mpinese/electronics-uldosc/bom.xlsx

Designator | Value | Footprint | DigiKey | Quantity
C1, C3 | 10u | Capacitor_THT:CP_Radial_D5.0mm_P2.00mm | P1176-ND | 2
C2 | 100n | Capacitor_SMD:C_1206_3216Metric | 445-6984-1-ND | 1
C4 | 47u | Capacitor_THT:CP_Radial_D6.3mm_P2.50mm | 493-10493-1-ND | 1
C5-C7 | 22n | Capacitor_THT:C_Rect_L7.2mm_W7.2mm_P5.00mm_FKS2_FKP2_MKS2_MKP2 | 1928-1227-ND | 3
C8 | 47p | Capacitor_SMD:C_0603_1608Metric | 1276-1037-1-ND | 1
C9, C10 | 1000u | Capacitor_THT:CP_Radial_D16.0mm_P7.50mm | 399-6557-ND | 2
C11, C12 | 1u | Capacitor_SMD:C_0603_1608Metric | 1276-1942-1-ND | 2
C13-C20 | 100n | Capacitor_SMD:C_0603_1608Metric | 399-7845-1-ND | 8
D1, D2 | BAV99 | Package_TO_SOT_SMD:SOT-23 | 1727-4311-1-ND | 2
D3, D4 | 1N5246B | Diode_THT:D_DO-35_SOD27_P7.62mm_Horizontal | 1N5246B-ND | 2
J1 | Conn_Coaxial | uld_osc:CONN_1-1337543-0 | A97553-ND | 1
Q1 | BC337 | Package_TO_SOT_THT:TO-92_Inline | BC33716TAFSCT-ND | 1
R1 | 510 | Resistor_SMD:R_0603_1608Metric | RR08P510DCT-ND | 1
R2 | 18 | Resistor_SMD:R_0603_1608Metric | RR08Q18DCT-ND | 1
R3 | 3.48k | Resistor_SMD:R_0603_1608Metric | RG16P3.48KBCT-ND | 1
R4 | 2.2k | Resistor_SMD:R_0603_1608Metric | RR08P510DCT-ND | 1
R6 | 5.6k | Resistor_SMD:R_0603_1608Metric | RR08P5.6KDCT-ND | 1
R7 | 8.2k | Resistor_SMD:R_0603_1608Metric | RR08P8.2KDCT-ND | 1
R8 | 715 | Resistor_SMD:R_0603_1608Metric | RR08P715DCT-ND | 1
R9 | 9.1k | Resistor_SMD:R_0603_1608Metric | RR08P9.1KDCT-ND | 1
R5, R10, R12, R14 | 3.6k | Resistor_SMD:R_0603_1608Metric | RG16P3.6KBCT-ND | 4
R11, R13, R15 | 10k | Resistor_SMD:R_0603_1608Metric | RR08P10.0KDCT-ND | 3
R16, R17 | 6.8 | Resistor_SMD:R_0805_2012Metric | 311-2897-1-ND | 2
U1 | NSL-32 | OptoDevice:Luna_NSL-32 | NSL-32SR3-ND | 1
U2, U6 | OPA1611 | Package_SO:SOIC-8_3.9x4.9mm_P1.27mm | 296-47811-1-ND | 2
U3 | TL431DBZ | Package_TO_SOT_SMD:SOT-23 | 296-17332-1-ND | 1
U4 | TL081 | Package_SO:SOIC-8_3.9x4.9mm_P1.27mm | 296-TL081CPSRCT-ND | 1
U5 | TL082 | Package_SO:SOIC-8_3.9x4.9mm_P1.27mm | 296-15005-1-ND | 1
VR1 | 200 | uld_osc:67YR200LF | 987-1503-ND | 1
VR2 | 50k | uld_osc:P160KN2 | 987-1714-ND | 1
K1 | Knob |  | 1722-1313-ND | 1
