mpinese/electronics-uldosc/kicad/uld_osc.kicad_pcb

## KiCad design kicad/uld_osc.kicad_pcb (2020-09-04)

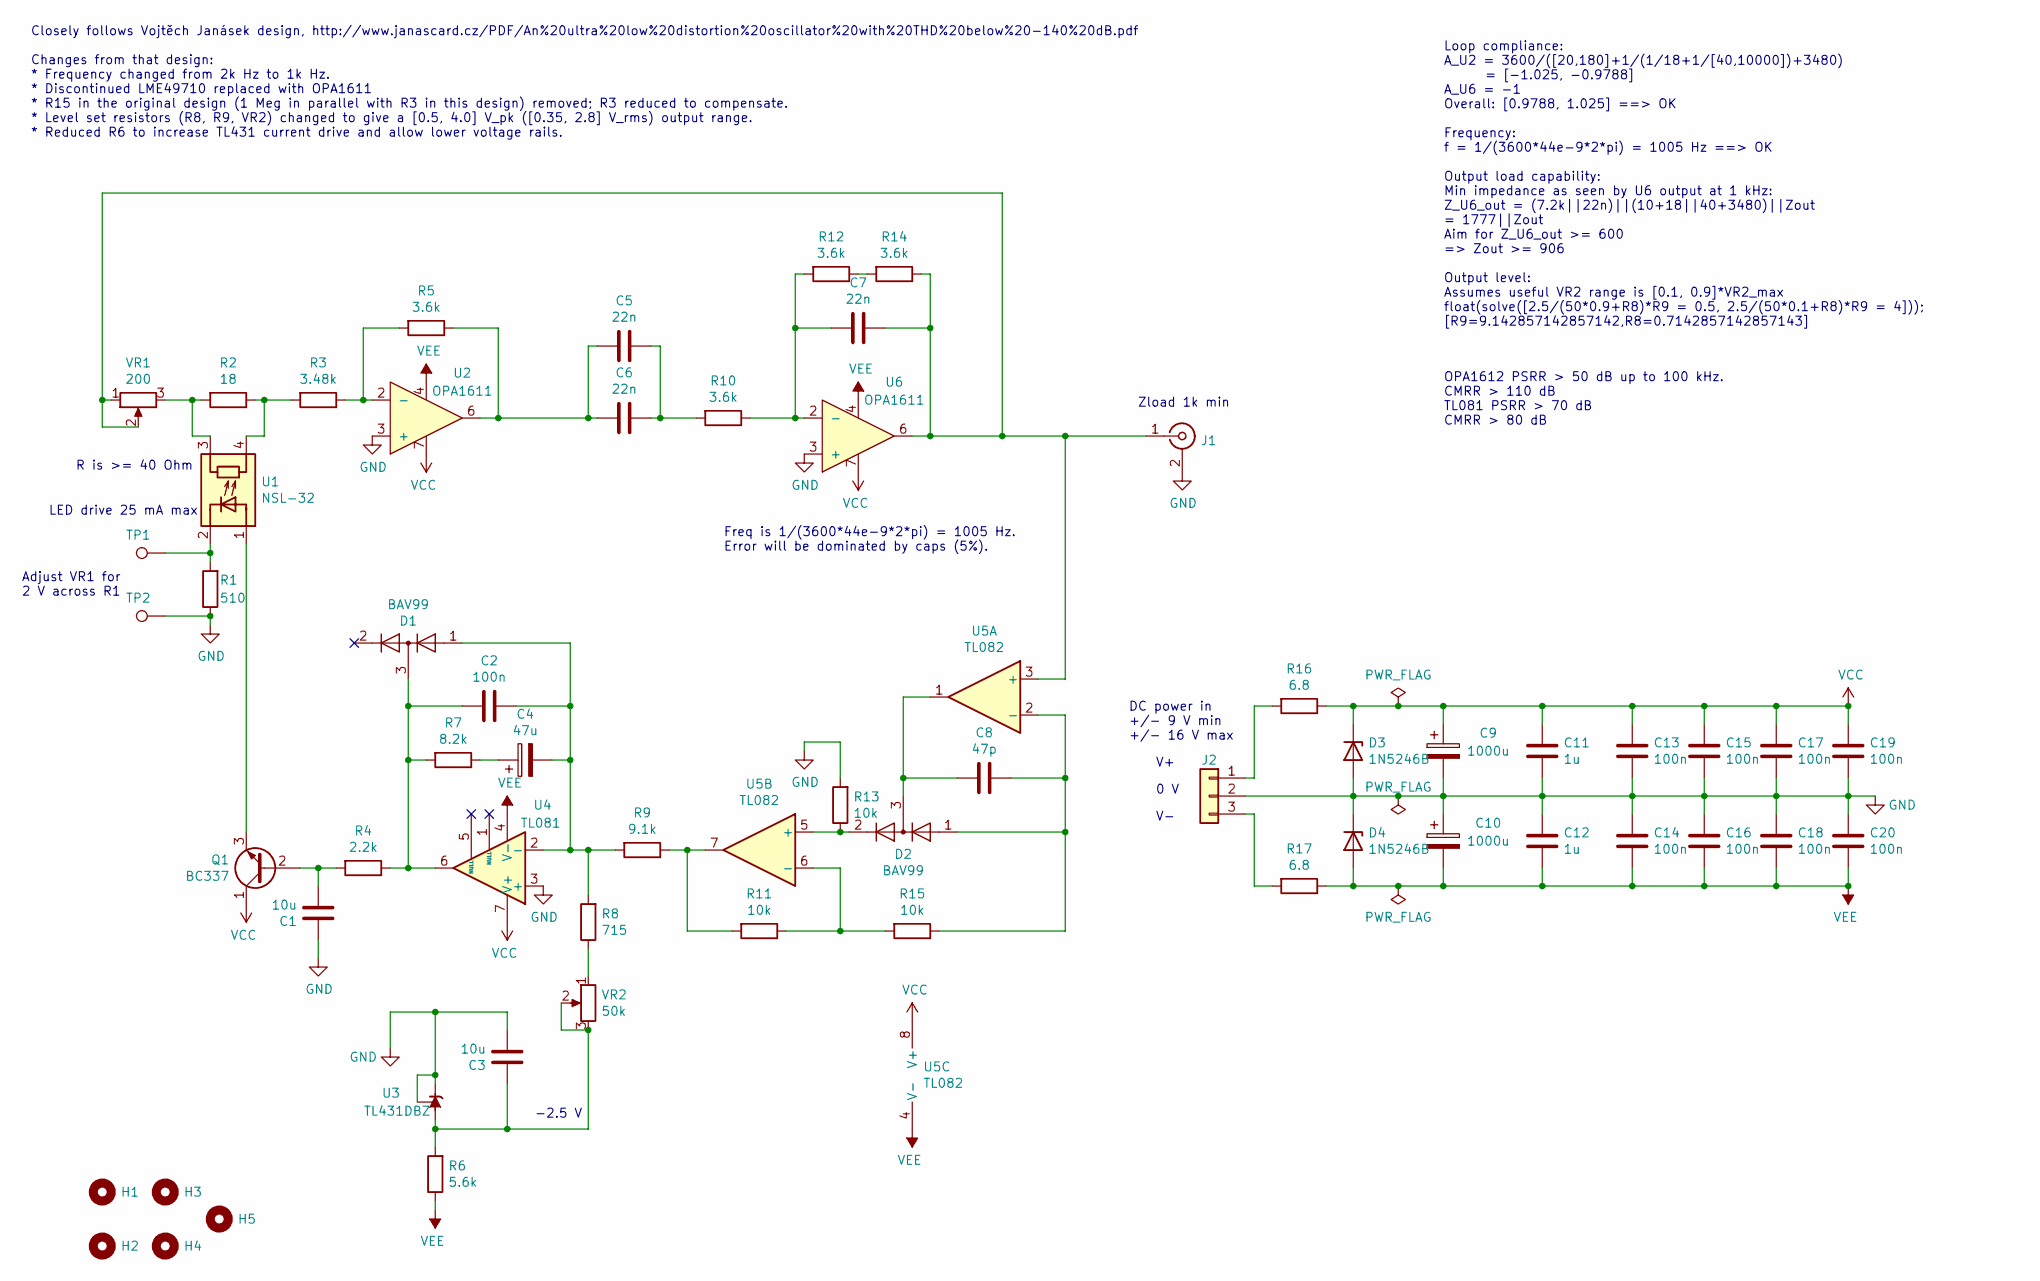
[picture p2: schematic uld_osc.sch, Low noise 1 kHz oscillator]

Parts:
C1, C3: 10u; CP_Radial_D5.0mm_P2.00mm; DigiKey P1176-ND
C2: 100n; C_1206_3216Metric; DigiKey 445-6984-1-ND
C4: 47u; CP_Radial_D6.3mm_P2.50mm; DigiKey 493-10493-1-ND
C5, C6, C7: 22n; C_Rect_L7.2mm_W7.2mm_P5.00mm_FKS2_FKP2_MKS2_MKP2; DigiKey 1928-1227-ND
C8: 47p; C_0603_1608Metric; DigiKey 1276-1037-1-ND
C9, C10: 1000u; CP_Radial_D16.0mm_P7.50mm; DigiKey 399-6557-ND
C11, C12: 1u; C_0603_1608Metric; DigiKey 1276-1942-1-ND
C13, C14, C15, C16, C17, C18, C19, C20: 100n; C_0603_1608Metric; DigiKey 399-7845-1-ND
D1, D2: BAV99; SOT-23; DigiKey 1727-4311-1-ND
D3, D4: 1N5246B; D_DO-35_SOD27_P7.62mm_Horizontal; DigiKey 1N5246B-ND
H1, H2, H3, H4, H5: MountingHole_3.2mm_M3
J1: Conn_Coaxial; CONN_1-1337543-0; DigiKey A97553-ND
J2: Conn_01x03; PinHeader_1x03_P2.54mm_Vertical
Q1: BC337; TO-92_Inline; DigiKey BC33716TAFSCT-ND
R1: 510; R_0603_1608Metric; DigiKey RR08P510DCT-ND
R2: 18; R_0603_1608Metric; DigiKey RR08Q18DCT-ND
R3: 3.48k; R_0603_1608Metric; DigiKey RG16P3.48KBCT-ND
R4: 2.2k; R_0603_1608Metric; DigiKey RR08P2.2KDCT-ND
R5, R10, R12, R14: 3.6k; R_0603_1608Metric; DigiKey RG16P3.6KBCT-ND
R6: 5.6k; R_0603_1608Metric; DigiKey RR08P5.6KDCT-ND
R7: 8.2k; R_0603_1608Metric; DigiKey RR08P8.2KDCT-ND
R8: 715; R_0603_1608Metric; DigiKey RR08P715DCT-ND
R9: 9.1k; R_0603_1608Metric; DigiKey RR08P9.1KDCT-ND
R11, R13, R15: 10k; R_0603_1608Metric; DigiKey RR08P10.0KDCT-ND
R16, R17: 6.8; R_0805_2012Metric; DigiKey 311-2897-1-ND
TP1, TP2: TestPoint; TestPoint_Loop_D2.50mm_Drill1.0mm
U1: NSL-32; Luna_NSL-32; DigiKey NSL-32SR3-ND
U2, U6: OPA1611; SOIC-8_3.9x4.9mm_P1.27mm; DigiKey 296-47811-1-ND
U3: TL431DBZ; SOT-23; DigiKey 296-17332-1-ND
U4: TL081; SOIC-8_3.9x4.9mm_P1.27mm; DigiKey 296-15001-1-ND
U5: TL082; SOIC-8_3.9x4.9mm_P1.27mm; DigiKey 296-15005-1-ND
VR1: 200; 67YR200LF; DigiKey 987-1503-ND
VR2: 50k; P160KN2; DigiKey 987-1714-ND

Connections:
GND: C1.2, C3.1, C9.2, C10.1, C11.2, C12.1, C13.2, C14.1, C15.2, C16.1, C17.2, C18.1, C19.2, C20.1, D3.2 (A), D4.1 (K), J1.2 (Ext), J2.2, R1.1, R13.2, TP2.1, U2.3 (+), U3.1 (K), U3.2 (REF), U4.3 (+), U6.3 (+)
unnamed: C1.1, Q1.2 (B), R4.2
unnamed: C2.1, C4.2, D1.1 (K), R8.2, R9.2, U4.2 (-)
unnamed: C2.2, D1.3 (K), R4.1, R7.2, U4.6
unnamed: C3.2, R6.2, U3.3 (A), VR2.2, VR2.3
unnamed: C4.1, R7.1
unnamed: C5.1, C6.1, R10.2
unnamed: C5.2, C6.2, R5.1, U2.6
unnamed: C7.1, J1.1 (In), R14.1, U5.3 (+), U6.6, VR1.1, VR1.2
unnamed: C7.2, R10.1, R12.2, U6.2 (-)
unnamed: C8.1, D2.1 (K), R15.1, U5.2 (-)
unnamed: C8.2, D2.3 (K), U5.1
unnamed: D2.2 (A), R13.1, U5.5 (+)
unnamed: J2.1, R16.2
unnamed: J2.3, R17.2
unnamed: Q1.3 (E), U1.1 (A)
unnamed: R1.2, TP1.1, U1.2 (K)
unnamed: R2.1, R3.2, U1.4 (R)
unnamed: R2.2, U1.3 (R), VR1.3
unnamed: R3.1, R5.2, U2.2 (-)
unnamed: R8.1, VR2.1
unnamed: R11.1, R15.2, U5.6 (-)
unnamed: R9.1, R11.2, U5.7
unnamed: R12.1, R14.2
VCC: C9.1, C11.1, C13.1, C15.1, C17.1, C19.1, D3.1 (K), Q1.1 (C), R16.1, U2.7, U4.7 (V+), U5.8 (V+), U6.7
VEE: C10.2, C12.2, C14.2, C16.2, C18.2, C20.2, D4.2 (A), R6.1, R17.1, U2.4, U4.4 (V-), U5.4 (V-), U6.4

Notes on the sheet:
-2.5 V
Closely follows Vojtěch Janásek design, http://www.janascard.cz/PDF/An%20ultra%20low%20distortion%20oscillator%20with%20THD%20below%20-140%20dB.pdf Changes from that design: * Frequency changed from 2k Hz to 1k Hz. * Discontinued LME49710 replaced with OPA1611 * R15 in the original design (1 Meg in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
LED drive 25 mA max
R is >= 40 Ohm
Loop compliance: A_U2 = 3600/([20,180]+1/(1/18+1/[40,10000])+3480) = [-1.025, -0.9788] A_U6 = -1 Overall: [0.9788, 1.025] ==> OK Frequency: f = 1/(3600*44e-9*2*pi) = 1005 Hz ==> OK Output load capability: Min impedance as seen by U6 output at 1 kHz: Z_U6_out = (7.2k||22n)||(10+18||40+3480)||Zout = 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
Freq is 1/(3600*44e-9*2*pi) = 1005 Hz. Error will be dominated by caps (5%).
Zload 1k min
Adjust VR1 for 2 V across R1
OPA1612 PSRR > 50 dB up to 100 kHz. CMRR > 110 dB TL081 PSRR > 70 dB CMRR > 80 dB
0 V
DC power in +/- 9 V min +/- 16 V max

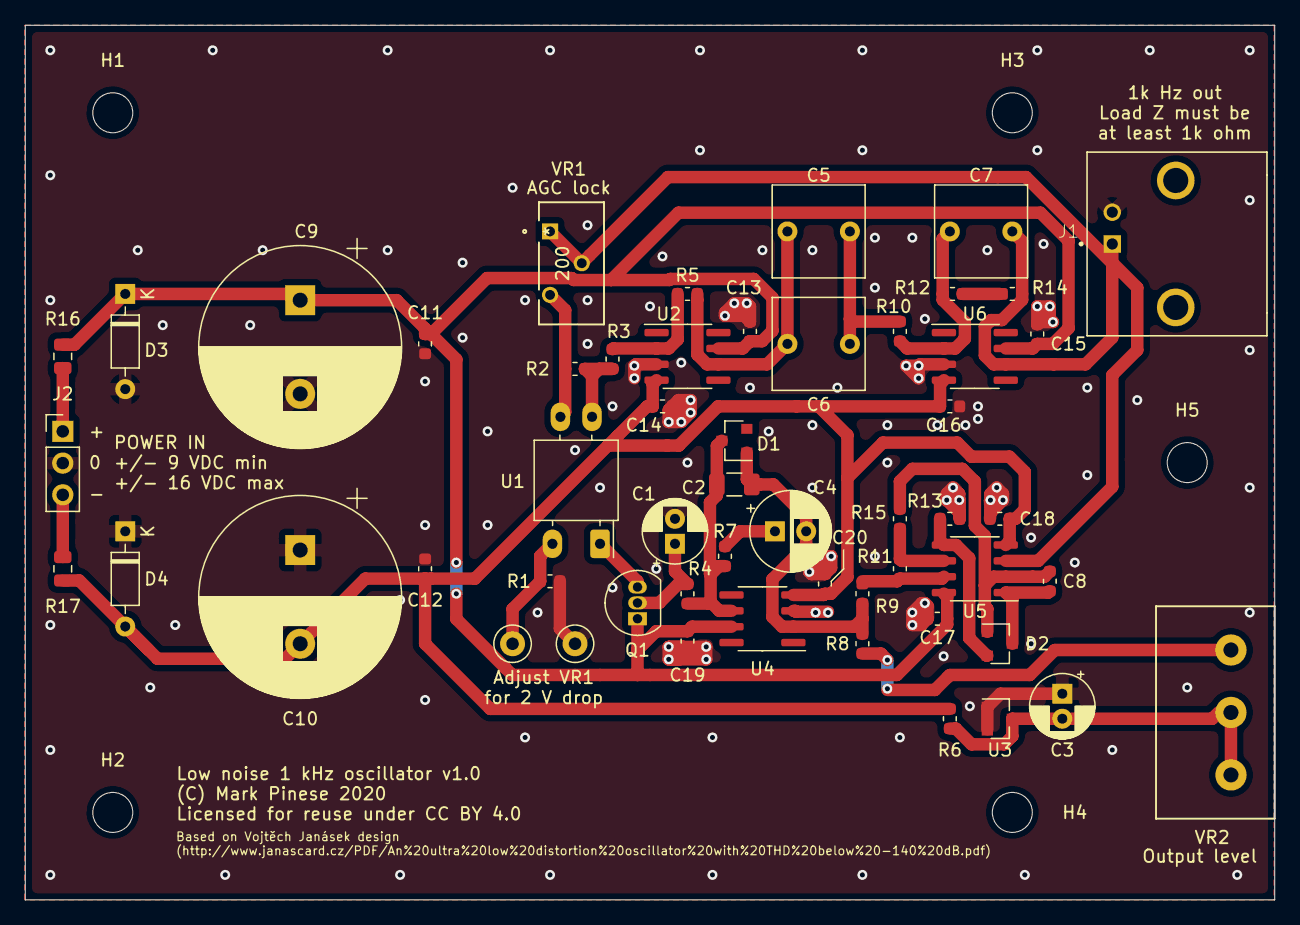
[picture p3: board uld_osc.kicad_pcb from above]

Board: 2 copper layers, 100.0 x 70.0 mm, 59 parts (0 on the bottom side), 26 nets.
