mpinese/electronics-uldosc/(commit log)

2020-09-04 Initial commit.
    [bom.xlsx, uld_osc.kicad_pcb, uld_osc.sch]
2020-09-04 Fixed pin 1 figure.
