mpinese/electronics-uldosc/(notices)

Notices in the files:
kicad/uld_osc.sch:
This work is licensed under a Creative Commons Attribution 4.0 International Licence.
kicad/uld_osc.kicad_pcb:
Licensed for reuse under CC BY 4.0
parts and their libraries:
Copyright 2016 Accelerated Designs. All rights reserved.
